anujmore23/Smart-Anti-Theft-Module-for-vehicles/Schematics/sim7600-module.jpg

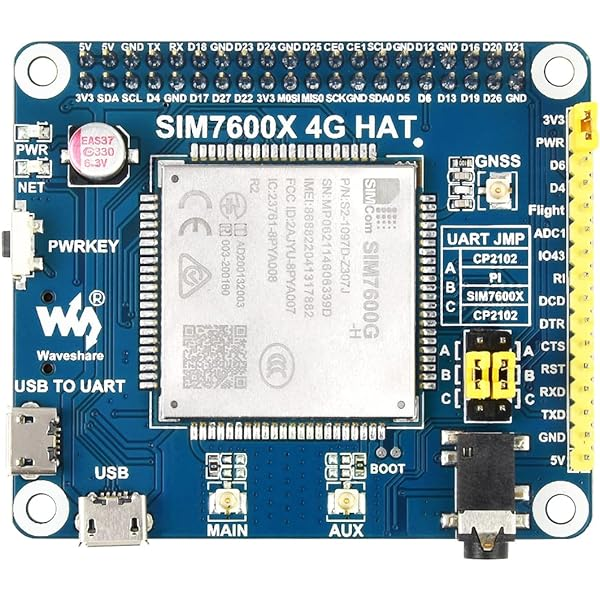
Schematics/sim7600-module.jpg
