anujmore23/Smart-Anti-Theft-Module-for-vehicles/Schematics/5V-single-channel-relay-module.webp

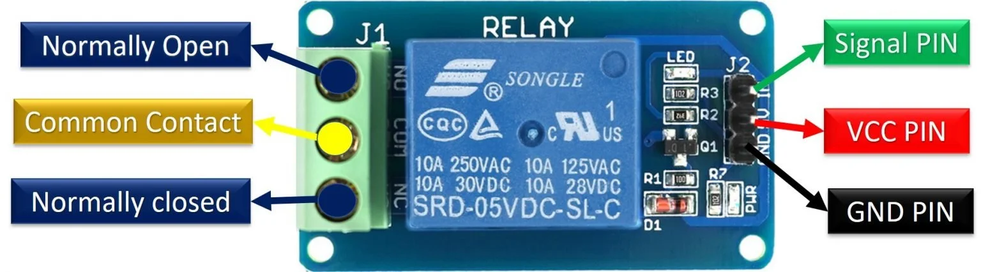
Schematics/5V-single-channel-relay-module.webp
