anujmore23/Smart-Anti-Theft-Module-for-vehicles/Schematics/gpsneo7m.png

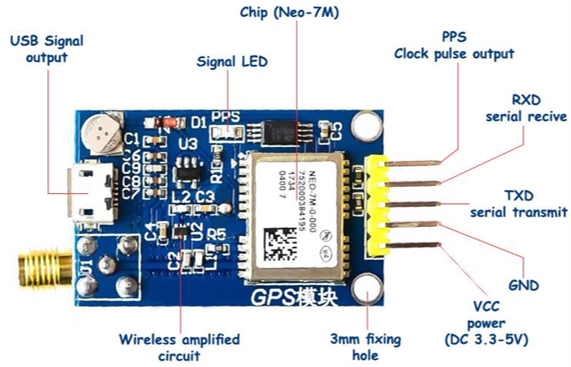
Schematics/gpsneo7m.png
