anujmore23/Smart-Anti-Theft-Module-for-vehicles/Schematics/satv_block-diagram.pdf

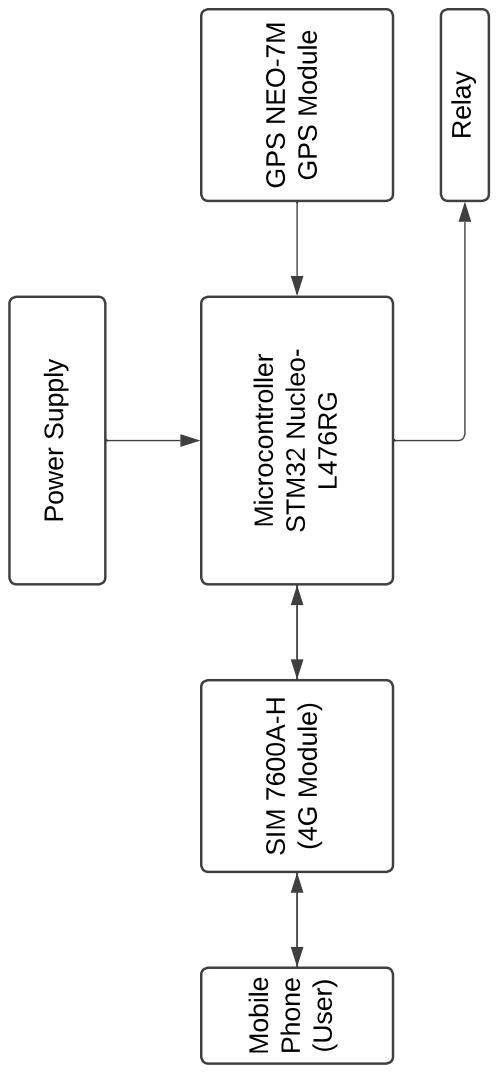
[picture p26: page 1]
