anujmore23/Smart-Anti-Theft-Module-for-vehicles/Firmware/SMS_based_Smart_Anti_Theft_modules_for_Vehicles.ioc

Mcu.UserName=STM32L476RGTx
PA10.Signal=USART1_RX
PA2.Signal=USART2_TX
PA3.Signal=USART2_RX
PA5.Signal=GPIO_Output
PA9.Signal=USART1_TX
PC10.Signal=USART3_TX
PC11.Signal=USART3_RX
PC13.GPIO_Label=B1 [Blue PushButton]
PC13.Signal=GPXTI13
